rode-o/Stepper_Controller_V0.00.00/images/stepper prototype image.jpg

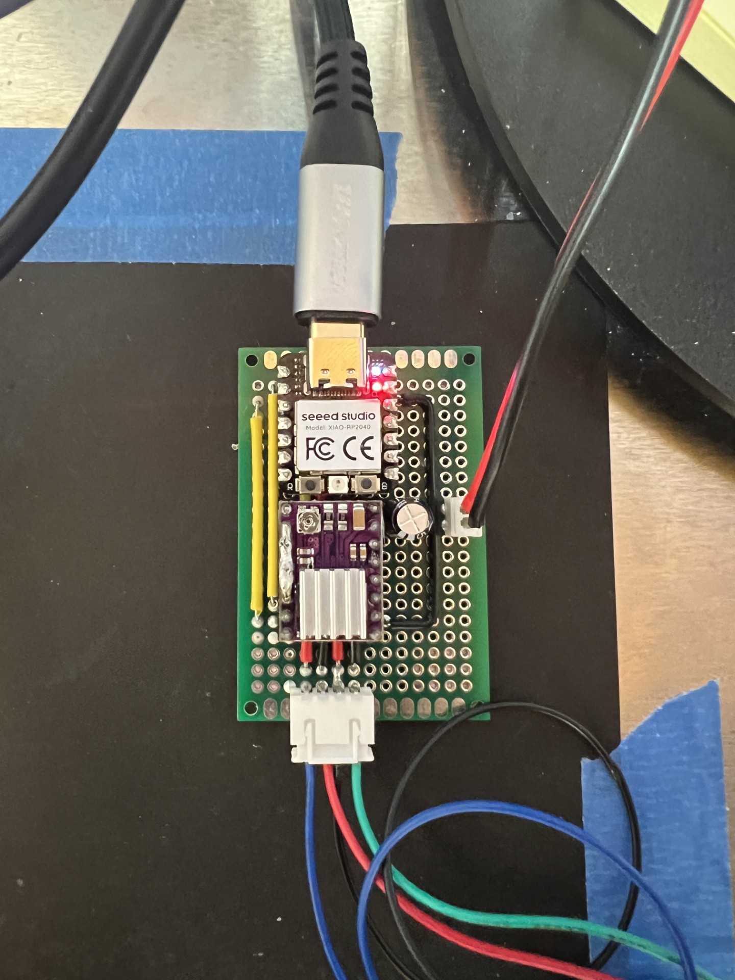
images/stepper prototype image.jpg
