rode-o/Stepper_Controller_V0.00.00/hardware/temp.csv

Net Code | Net Name | Pad Count | Via Count | Via Length (mm) | Track Length (mm) | Die Length (mm) | Net Length (mm) | F.Cu (mm) | GND (mm) | 24V (mm) | B.Cu (mm)
002 | /M2 | 3 | 1 | 1.5450 | 20.0077 | 0.0000 | 21.5527 | 11.6474 | 0.0000 | 0.0000 | 8.3603
003 | /M1 | 3 | 0 | 0.0000 | 14.8706 | 0.0000 | 14.8706 | 0.0000 | 0.0000 | 0.0000 | 14.8706
004 | /3_3 | 6 | 1 | 1.5450 | 112.3838 | 0.0000 | 113.9288 | 43.1061 | 0.0000 | 0.0000 | 69.2777
005 | Net-(A1-B1) | 2 | 0 | 0.0000 | 30.5111 | 0.0000 | 30.5111 | 0.0000 | 0.0000 | 0.0000 | 30.5111
006 | /EN | 3 | 0 | 0.0000 | 19.3708 | 0.0000 | 19.3708 | 0.5091 | 0.0000 | 0.0000 | 18.8616
007 | Net-(A1-A1) | 2 | 0 | 0.0000 | 30.4945 | 0.0000 | 30.4945 | 0.0000 | 0.0000 | 0.0000 | 30.4945
009 | /M0 | 3 | 0 | 0.0000 | 20.6795 | 0.0000 | 20.6795 | 0.3274 | 0.0000 | 0.0000 | 20.3522
010 | /STP | 3 | 0 | 0.0000 | 44.2562 | 0.0000 | 44.2562 | 44.2562 | 0.0000 | 0.0000 | 0.0000
011 | Net-(A1-A2) | 2 | 0 | 0.0000 | 30.4779 | 0.0000 | 30.4779 | 0.0000 | 0.0000 | 0.0000 | 30.4779
012 | /DIR | 3 | 0 | 0.0000 | 44.4702 | 0.0000 | 44.4702 | 44.4702 | 0.0000 | 0.0000 | 0.0000
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
