rode-o/Stepper_Controller_V0.00.00/hardware/stepper_driver/bom/stepperBOM_V0.00.00.xlsx

Board Quantity | Column1 | References | Column2 | Value/PN | Footprint | Quantity per board | Total Needed | Unit Price | # In Unit | Total Part Cost | Link
10 | 1 | C2 | 10 mf cap | FG11X7R1H106KRT06 | CAPRB250W50L550T400H700 | 1 | 10 | 1.39 | 1 | 13.9 | https://www.digikey.com/en/products/detail/tdk-corporation/FG11X7R1H106KRT06/5802731
10 | 2 | C3 | 22 mf cap | FK11X7R1A226MR020 | CAPRB250W50L550T400H700 | 1 | 10 | 0.73 | 1 | 7.3 | https://www.digikey.com/en/products/detail/tdk-corporation/fk11x7r1a226mr020/2815189
10 | 3 | U1 | MC Breakout | XIAO RP2040 | XIAO-RP2040-DIP | 1 | 10 | 4.68 | 1 | 46.8 | https://www.digikey.com/en/products/detail/seeed-technology-co-ltd/102010428/14672129
10 | 4 | U3 | Screen Module | OLED | RPi_Pico_SMD_TH | 1 | 10 | 9.99 | 1 | 99.9 | https://www.digikey.com/en/products/detail/seeed-technology-co-ltd/103030401/14317038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
10 | 5 | F1 | 3A Fuse | BK_PCB-3-R | BKPCB3R | 1 | 10 | 3.42 | 1 | 34.2 | https://www.digikey.com/en/products/detail/eaton-electronics-division/BK-PCB-3-R/954341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
10 | 6 | A1 | Driver Breakout | Pololu_Breakout_DRV8825 | Pololu_Breakout-16_15.2x20.3mm | 1 | 10 | 77.95 | 5 | 155.9 | https://www.digikey.com/en/products/detail/pololu-corporation/2987/10450470?gad_source=1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
10 | 7 | PS1 | Buck Convertor | TSR_1-2450E | CONV_TSR_1-2450E | 1 | 10 | 4.37 | 1 | 43.7 | https://www.digikey.com/en/products/detail/traco-power/TSR-1-2450E/12171283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
10 | 8 | J1 | Motor Connector Male | B4B-XH-A | B4B-XH-A | 1 | 10 | 0.23 | 1 | 2.3 | https://www.digikey.com/en/products/detail/jst-sales-america-inc/B4B-XH-A/1651047
10 | 9 | J2 | Barrel Jack | PJ-067B | CUI_PJ-067B | 1 | 10 | 2.88 | 1 | 28.8 | https://www.digikey.com/en/products/detail/same-sky-formerly-cui-devices/PJ-067B/2627228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
10 | 10 | P1 | Sensor Connector | 530470610 | 530470610 | 1 | 10 | 0.37 | 1 | 3.7 | https://www.digikey.com/en/products/detail/molex/0530470610/242857?s=N4IgTCBcDaIKwGYAMAWA7AWiQNgIxJAF0BfIA
10 | 11 | N/A | Motor Lead Crimps | SXH-002T-P0.6 | N/A | 4 | 40 | 0.1 | 1 | 4 | https://www.digikey.com/en/products/detail/jst-sales-america-inc/SXH-002T-P0-6/1651063
10 | 12 | N/A | Motor Connector Female | XHP-4 | N/A | 1 | 10 | 0.17 | 1 | 1.7 | https://www.digikey.com/en/products/detail/jst-sales-america-inc/XHP-4/683353
10 | 13 | N/A | 7 pos breakout rcpt | 21601X7GSE | N/A | 2 | 20 | 0.71 | 1 | 14.2 | https://www.digikey.com/en/products/detail/marutsuelec/21601X7GSE/21669028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
10 | 14 | N/A | 8 pos breakout rcpt | 21601X8GSE | N/A | 2 | 20 | 0.75 | 1 | 15 | https://www.digikey.com/en/products/detail/marutsuelec/21601X8GSE/21669138
10 | 15 | N/A | Display extended header | DW-20-08-L-S-200 | N/A | 2 | 20 | 2.57 | 1 | 51.4 | https://www.digikey.com/en/products/detail/samtec-inc/DW-20-08-L-S-200/6753034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
10 | 16 | N/A | Sensor Cable Complete | 151340601 | N/A | 1 | 10 | 5.06 | 1 | 50.6 | https://www.digikey.com/en/products/detail/molex/0151340601/6198155
10 | 17 | PCB | PCB | V0.00.00 | N/A | 1 | 10 | 9.746 | 5 | 19.492 | N/A
10 | 18 | N/A | M2 heat seat inserts | N/A | N/A | 15 | 150 | 9.99 | 70 | 21.40714286 | https://www.amazon.com/ruthex-Threaded-Insert-pieces-ultrasound/dp/B088QJG676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
10 | 19 | N/A | 20mm m2x0.4 | 91292A335 | N/A | 4 | 40 | 6.97 | 100 | 2.788 | https://www.mcmaster.com/products/screws/socket-head-screws-2~/18-8-stainless-steel-socket-head-screws-11/thread-size~m2/
10 | 20 | N/A | 8mm m2x0.4 | 91292A832 | N/A | 3 | 30 | 7.12 | 100 | 2.136 | https://www.mcmaster.com/products/screws/socket-head-screws-2~/18-8-stainless-steel-socket-head-screws-11/thread-size~m2/
10 | 21 | N/A | 5mm m2x0.4 | 91292A005 | N/A | 8 | 80 | 14.26 | 100 | 11.408 | https://www.mcmaster.com/products/screws/socket-head-screws-2~/18-8-stainless-steel-socket-head-screws-11/thread-size~m2/
10 | 22 | N/A | 24V @ 1.5 Apower supply | WSU240-1500-R13 | N/A | 1 | 10 | 30.39 | 1 | 303.9 | https://www.digikey.com/en/products/detail/triad-magnetics/WSU240-1500-R13/6600130?gad_source=1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
10 | 23 | N/A | usbC to A | 1528-5031-ND | N/A | 1 | 34 | 3.95 | 1 | 134.3 | https://www.digikey.com/en/products/detail/adafruit-industries-llc/5031/14625566?gad_source=1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
Cost per unit
106.8831143
Grand total
1068.831143
