rode-o/Stepper_Controller_V0.00.00/hardware/stepper_driver/stepper_driver_plugin.step

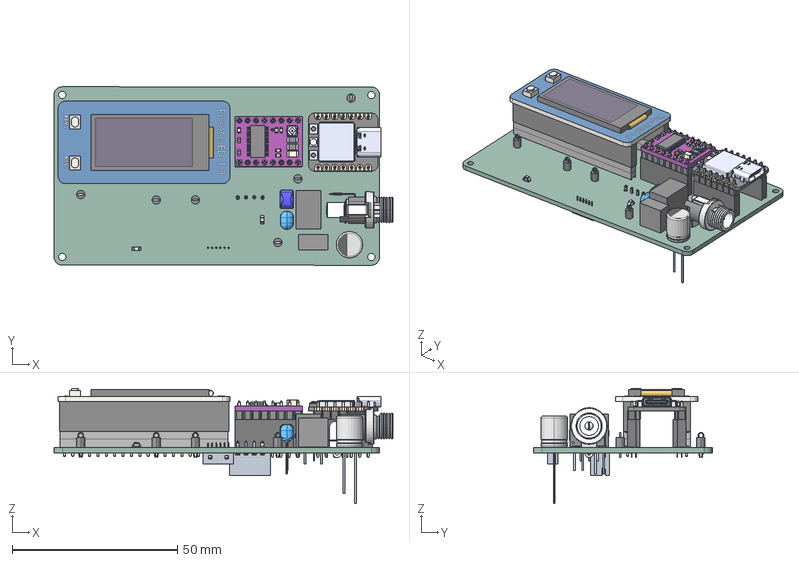
[picture p2: CAD file, 2025-07-09]
hardware/stepper_driver/stepper_driver_plugin.step
102.6 x 54.0 x 34.9 mm
FA11C0G2A683JNU00
B4B-XH-A
³8 SIZE CODE F
ASSEMBLY
FK11C0G1H104JN006
TSR 1-2433E
PinHeader_1x07_P254mm_Vertical x 2
PinSocket_1x07_P2.54mm_Vertical x 2
DW-20-08-T-S-200 x 2
DRV8825 STEPPER MOTOR DRIVER CARRIER
PinSocket_1x08_P2.54mm_Vertical x 2
CUI_DEVICES_PJ-067B
_autosave-stepper_driver_plugin_PCB
