rode-o/Stepper_Controller_V0.00.00/(list of files, cad)

Other CAD files:
images/logo.SLDPRT
