rode-o/Stepper_Controller_V0.00.00/hardware/stepper_driver/stepper_driver_plugin.kicad_pcb

## KiCad design hardware/stepper_driver/stepper_driver_plugin.kicad_pcb (2025-06-03)

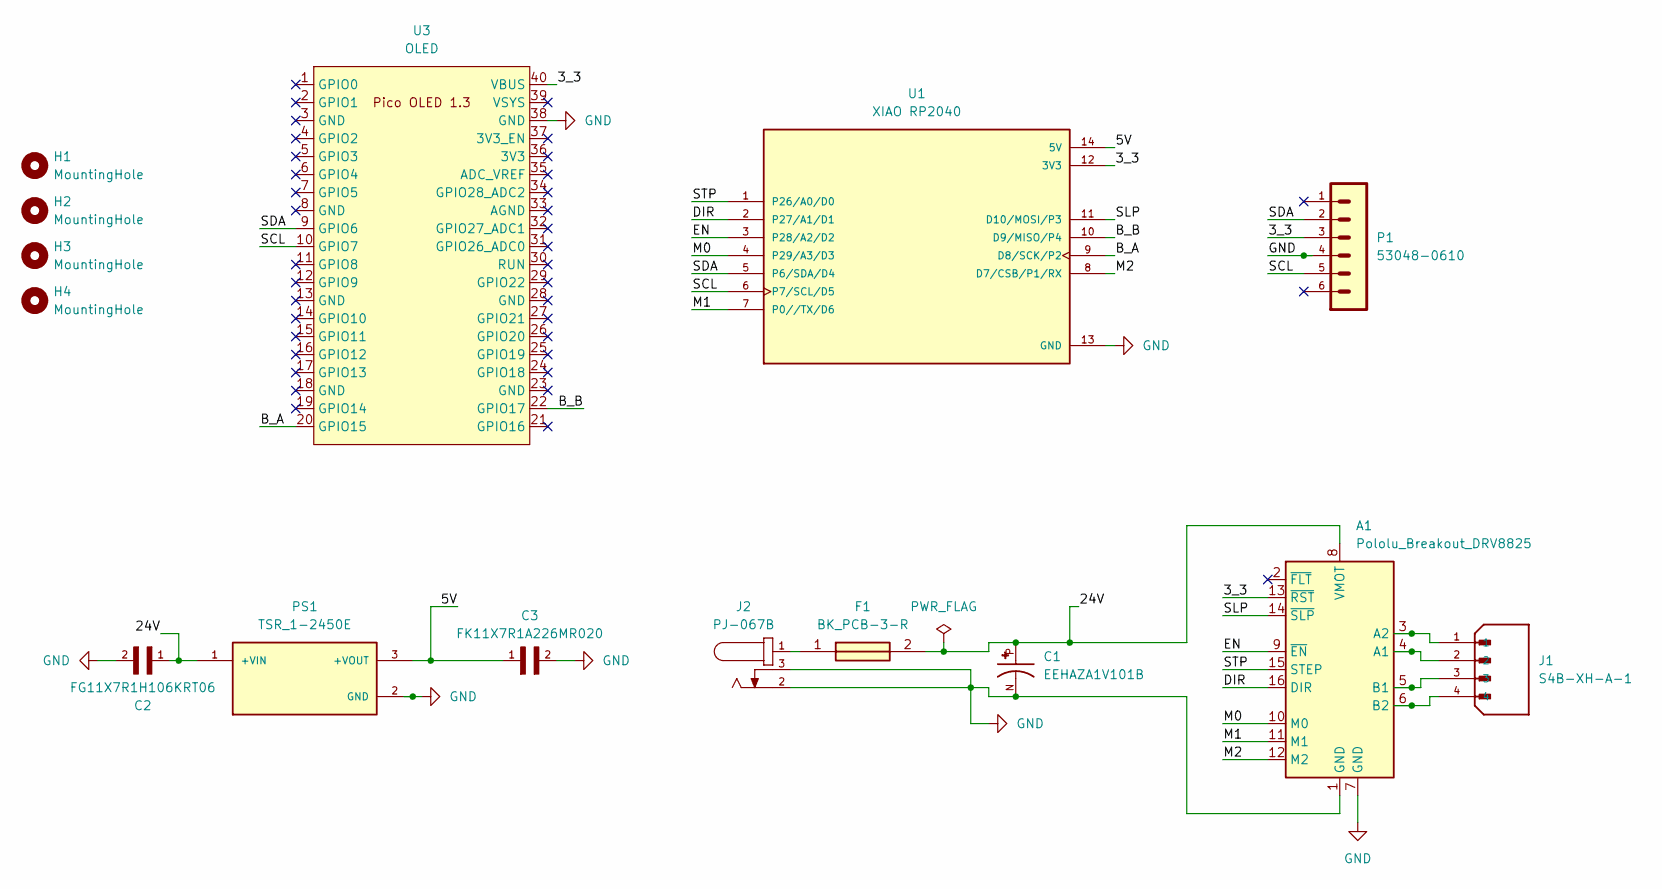
[picture p3: schematic stepper_driver_plugin.kicad_sch]

Parts:
A1: Pololu_Breakout_DRV8825; Pololu_Breakout-16_15.2x20.3mm
C1: EEHAZA1V101B; PARTREV 10-MAY-21; DigiKey_Part_Number 10-EEH-AZA1V101BCT-ND
C2: FG11X7R1H106KRT06; CAPRB250W50L550T400H700; PARTREV 20200310; DigiKey_Part_Number 445-173117-1-ND
C3: FK11X7R1A226MR020; CAPRB250W50L550T400H700; PARTREV 20151209; DigiKey_Part_Number 445-8259-ND
F1: BK_PCB-3-R; BKPCB3R; Mouser Part Number 504-BK/PCB-3-R
H1, H2, H3, H4: MountingHole; MountingHole_2.2mm_M2
J1: S4B-XH-A-1; JST_S4B-XH-A-1; PARTREV 27-1-20
J2: PJ-067B; CUI_PJ-067B; PARTREV 1.02
P1: 53048-0610; DigiKey_Part_Number WM1746-ND
PS1: TSR_1-2450E; CONV_TSR_1-2450E; PARTREV May 25, 2020; DigiKey_Part_Number 1951-TSR1-2450E-ND
U1: XIAO RP2040; XIAO-RP2040-DIP; PARTREV 1.3
U3: OLED; RPi_Pico_SMD_TH

Connections:
/3_3: A1.13 (~RST), P1.3, U1.12 (3V3), U3.40 (VBUS)
/5V: C3.1, PS1.3 (+VOUT), U1.14 (5V)
/24V: A1.8 (VMOT), C1.P, C2.1, F1.2, PS1.1 (+VIN)
/B_A: U1.9 (D8/SCK/P2), U3.20 (GPIO15)
/B_B: U1.10 (D9/MISO/P4), U3.22 (GPIO17)
/DIR: A1.16 (DIR), U1.2 (P27/A1/D1)
/EN: A1.9 (~EN), U1.3 (P28/A2/D2)
/M0: A1.10 (M0), U1.4 (P29/A3/D3)
/M1: A1.11 (M1), U1.7 (P0//TX/D6)
/M2: A1.12 (M2), U1.8 (D7/CSB/P1/RX)
/SCL: P1.5, U1.6 (P7/SCL/D5), U3.10 (GPIO7)
/SDA: P1.2, U1.5 (P6/SDA/D4), U3.9 (GPIO6)
/SLP: A1.14 (~SLP), U1.11 (D10/MOSI/P3)
/STP: A1.15 (STEP), U1.1 (P26/A0/D0)
unnamed: A1.4 (A1), J1.2
unnamed: A1.3 (A2), J1.1
unnamed: A1.5 (B1), J1.3
unnamed: A1.6 (B2), J1.4
unnamed: F1.1, J2.1

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
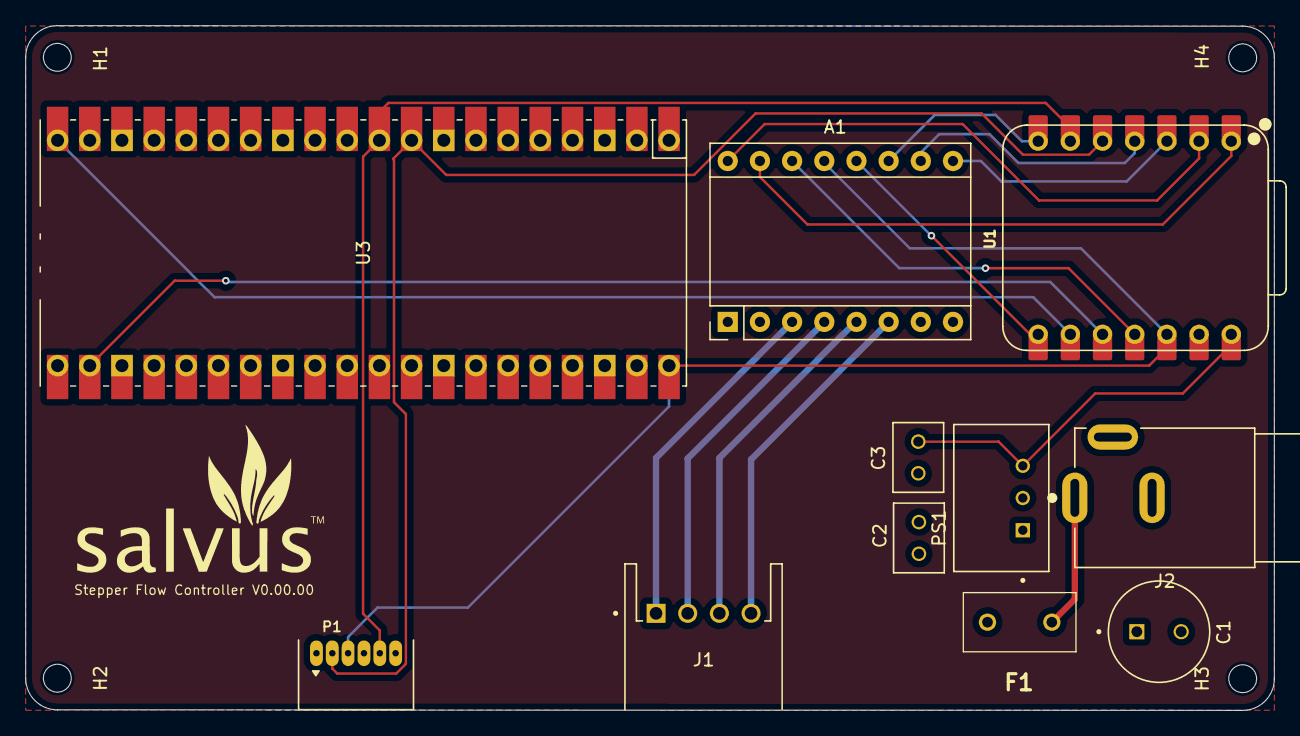
[picture p4: board stepper_driver_plugin.kicad_pcb from above]

Board: 4 copper layers, 98.6 x 54.0 mm, 15 parts (0 on the bottom side), 20 nets.
