rode-o/Stepper_Controller_V0.00.00/firmware/src/devices/RGB/rgb.hpp

#pragma once

#include "../../include/_include.hpp" 
// ^ adjust relative path if your tree differs.

namespace RGB {
    void begin();
    void setColour(LEDColour c);

    /* animation helpers (added earlier) */
    void loopCool();    // CLOSED-mode pump-ON
    void loopWarm();    // OPEN-mode  pump-ON
}
