rode-o/Stepper_Controller_V0.00.00/firmware/src/devices/pump_drivers/drv8825/drv8825.hpp

#pragma once
/* drv8825.hpp – 1/32-µstep pump driver for RP2040, AVR, bit-bang */

#include "../../../include/_include.hpp"   // pins, feature flags
#include <Arduino.h>

#ifdef ENABLE_DRV8825
namespace PumpDrv {

/* ---------- tuning constants -------------------------------- */
constexpr uint32_t MICROSTEP_DIV       = 32;        // 1/32-step
constexpr uint32_t MAX_FULL_SPS        = 1200;      // full-steps / s
constexpr uint32_t MAX_SPS             = MAX_FULL_SPS * MICROSTEP_DIV;
constexpr uint32_t MIN_SPS             = 20;
constexpr uint32_t ACCEL_SPS_PER_CYCLE = 0;         // 0 = instant

/* ---------- public API -------------------------------------- */
void  initPump();

/* speed-based interface (compat) */
void  setTargetSPS(float sps);
void  setTargetRPM(float rpm);
void  pumpService();
float currentSPS();

/* period-driven interface (preferred) */
void  setTop(uint16_t top);             // 0 ⇒ stop / disable output

/* ---------- fail-safe helper -------------------------------- */
inline void stop() { setTop(0); }       // always safe to call

} // namespace PumpDrv
#endif
