rode-o/Stepper_Controller_V0.00.00/firmware/src/ctrl/utils_ctrl/utils_ctrl.hpp

#pragma once
#include "../../main.hpp"

/*  utils_ctrl.hpp – math, filters & volume helpers shared by all controllers  */

constexpr double PWM_CLKDIV    = 64.0;                    // slice divider
constexpr float  STEPS_PER_REV = 200.0f * PumpDrv::MICROSTEP_DIV;

/* wrap / rate helpers */
uint16_t rateToTop(double uLmin);   // flow-to-PWM helper (µL min-¹ → TOP)
float    topToSps(uint16_t top);    // TOP → steps s-¹
uint16_t spsToTop(float sps);       // steps s-¹ → TOP

/* sensor + bookkeeping */
float readAndFilterFlow();          // returns filtered flow, pushes raw
void  updateVolume(float flow_uLmin, uint32_t dtMs);
