rode-o/Stepper_Controller_V0.00.00/(commit log)

2025-06-23 adding alot, intial firmware included
    [stepper_driver_plugin.kicad_sch]
2025-06-29 broken pid, everything else is relatively good
    [SFL3S-0600F.cpp, SFL3S-0600F.hpp, buttons_two.cpp, buttons_two.hpp, config.hpp, drv8825.cpp, drv8825.hpp]
2025-07-02 firmware changes and PCB update
2025-07-06 added srl_cmd and some ui changes - fixed rpm conversion error
    [CommandParser.cpp, CommandParser.h, SFL3S-0600F.cpp, SFL3S-0600F.hpp, StepperController.cpp, StepperController.h]
2025-07-09 added some flow study script and added volume accum to ui
    [output.csv, stepper_driver_plugin.step]
2025-07-14 added calibration sequence
    [device_1.csv, device_2.csv, device_3.csv, output.csv, output_demux.csv, output_unified.csv]
